LTHeaven/QLOCKOPlagiat/BndUhr/BndUhr.pdf

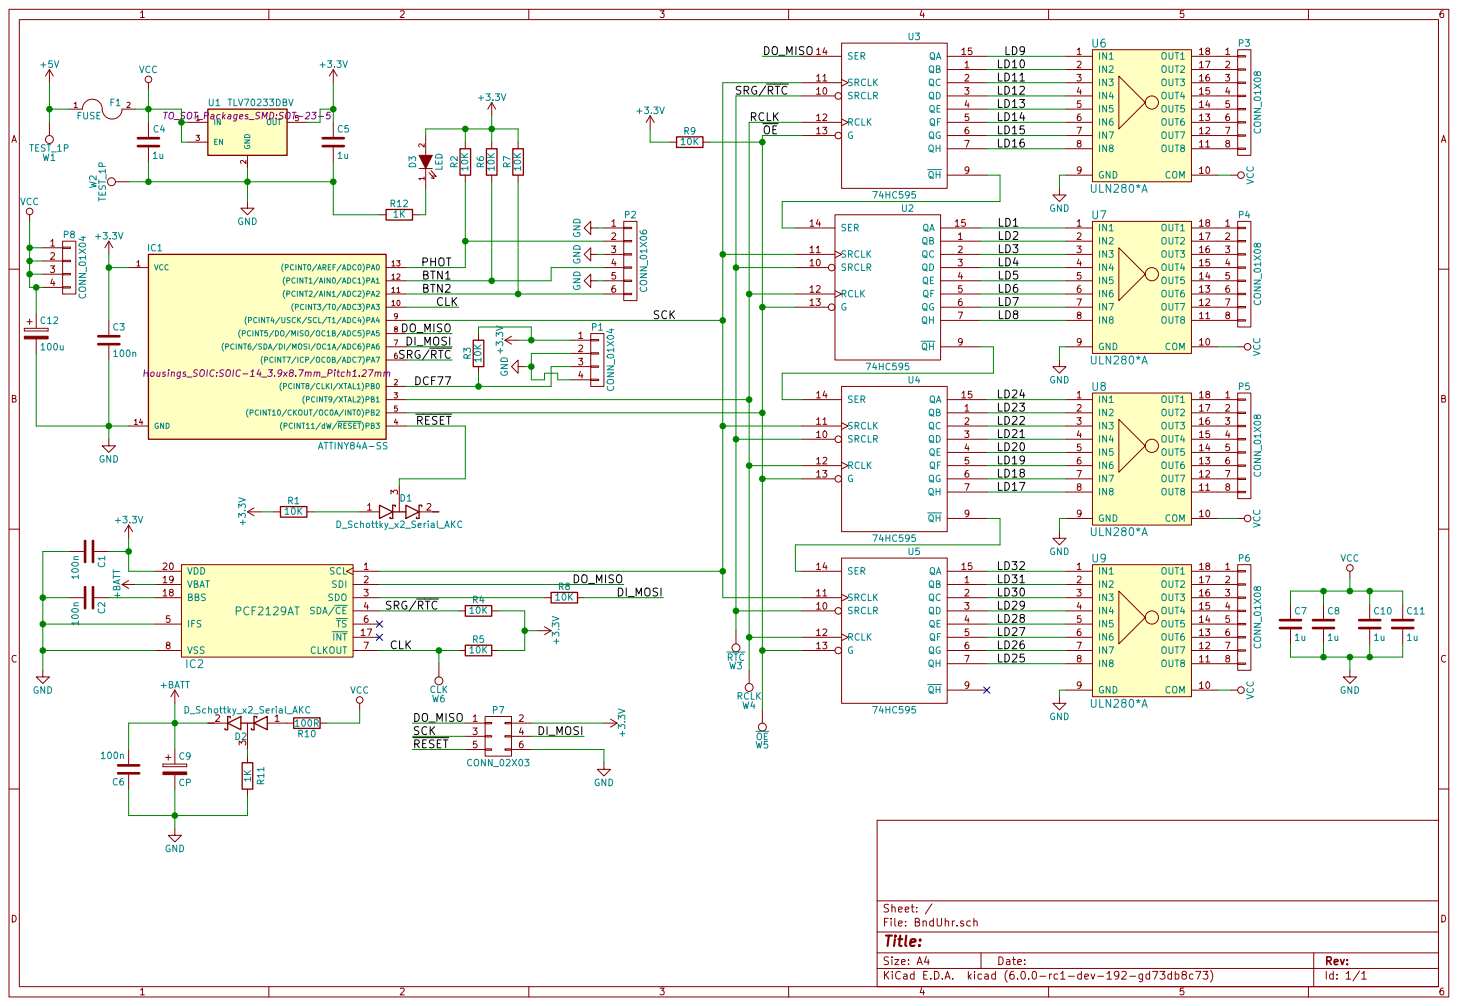
[picture p1: page 1]

LD10 | IN2 2
LD11 | IN3 3

LD20 | IN5 5
LD19 | IN6 6
LD18 | IN7 7
LD17

LD28 | IN5 5
LD27 | IN6 6
LD26 | IN7 7
LD25

Id: 1/1 Title: File: BndUhr.sch Sheet: /
