LTHeaven/QLOCKOPlagiat/BndUhr/BndUhr.kicad_pcb

## KiCad design BndUhr/BndUhr.kicad_pcb (2018-09-23)

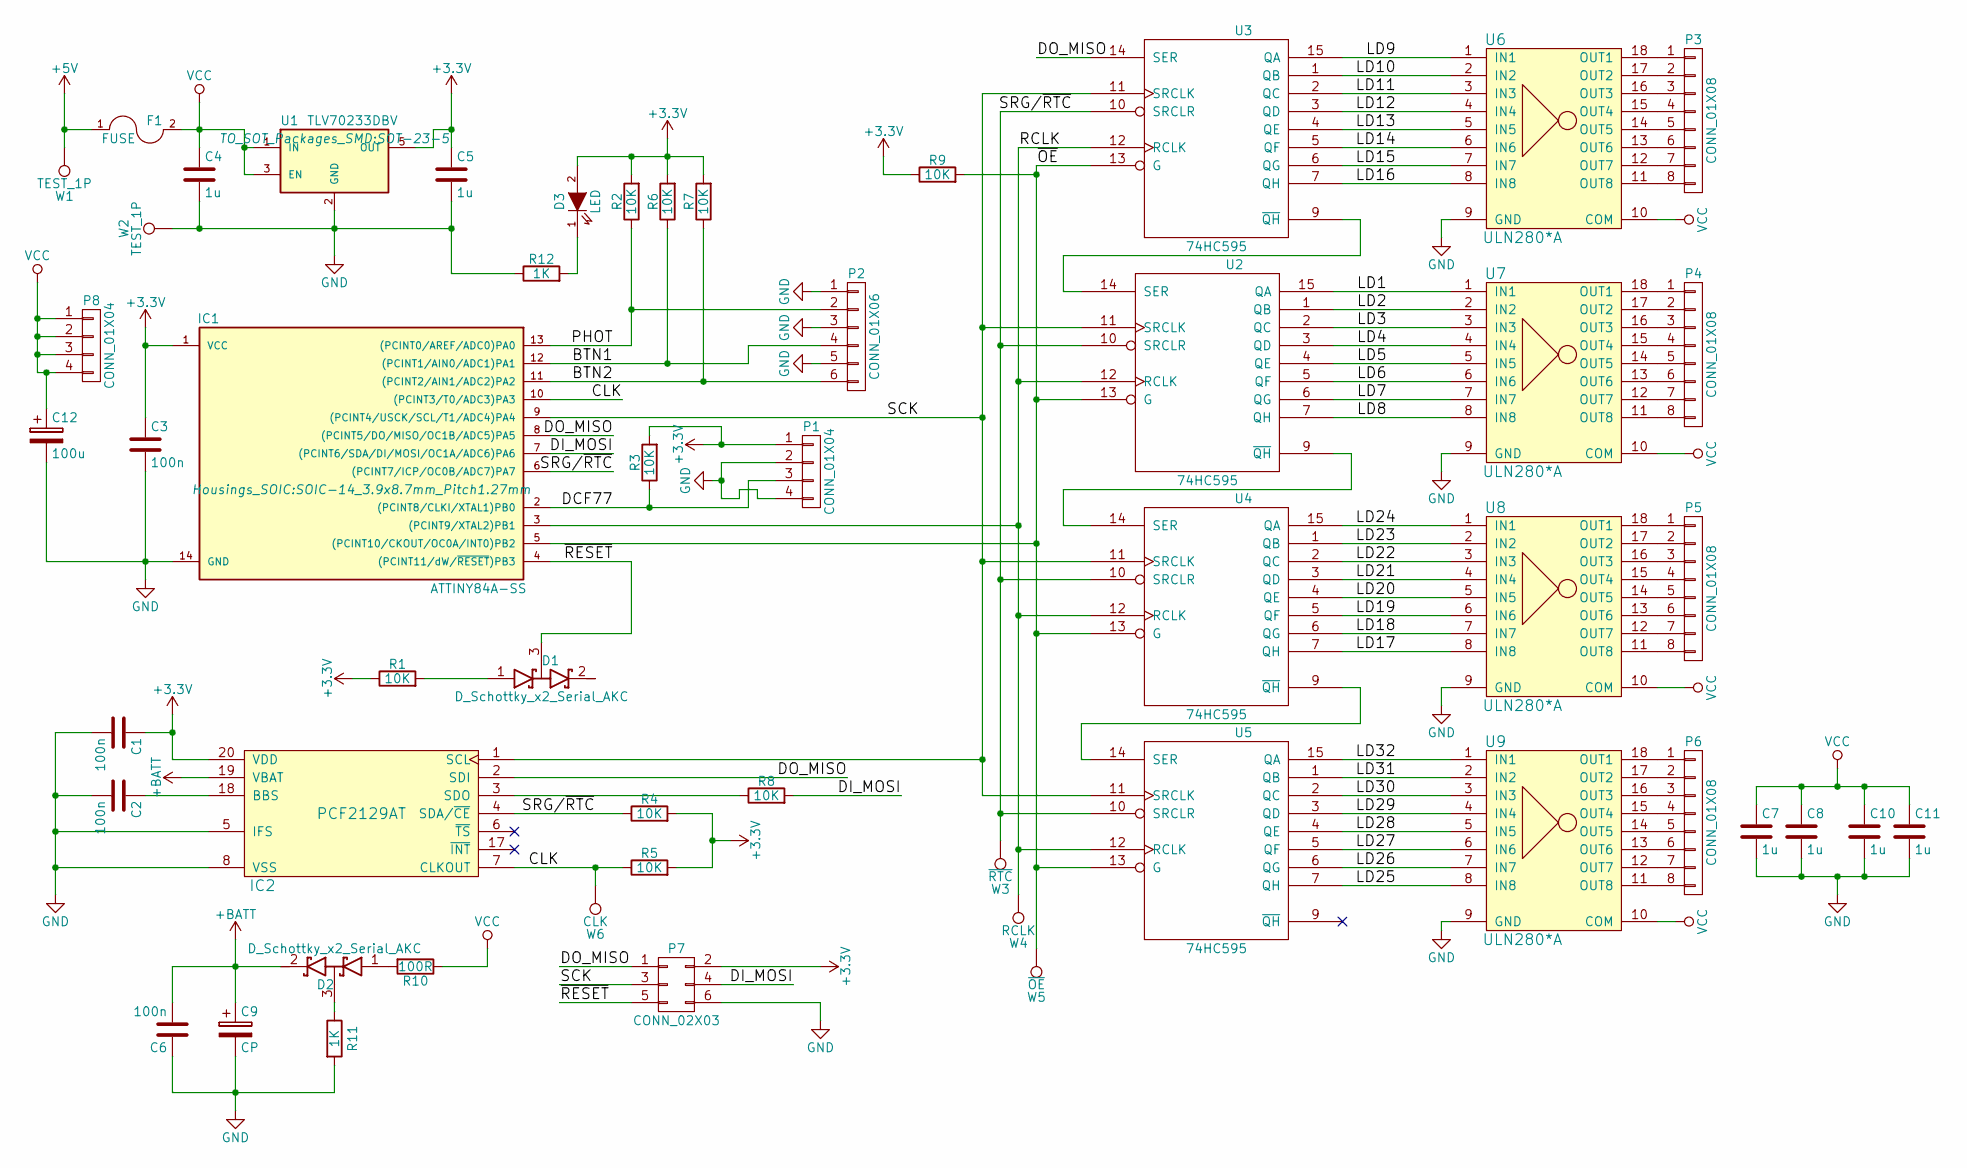
[picture p2: schematic BndUhr.sch]

Parts:
C1, C2, C3, C6: 100n; C_0603
C4, C5, C7, C8, C10, C11: 1u; C_0603
C9: CP; Panasonic-SuperCap-20mm
C12: 100u; CP_Radial_D8.0mm_P5.00mm
D1, D2: D_Schottky_x2_Serial_AKC; SOT-23
D3: LED; LED_1206
F1: FUSE; Fuseholder5x20_horiz_open_universal_Type-III
IC1: ATTINY84A-SS; SOIC-14_3.9x8.7mm_Pitch1.27mm
IC2: PCF2129AT; SOIC-20W_7.5x12.8mm_Pitch1.27mm
P1, P8: CONN_01X04; Pin_Header_Straight_1x04_Pitch2.54mm
P2: CONN_01X06; Pin_Header_Straight_1x06_Pitch2.54mm
P3, P4, P5, P6: CONN_01X08; Pin_Header_Angled_1x08_Pitch2.54mm
P7: CONN_02X03; IDC_Header_Straight_6pins
R1, R2, R3, R4, R5, R6, R7, R8, R9: 10K; R_0603
R10: 100R; R_0603
R11, R12: 1K; R_0603
U1: TLV70233DBV; SOT-23-5
U2, U3, U4, U5: 74HC595; SOIC-16_3.9x9.9mm_Pitch1.27mm
U6, U7, U8, U9: ULN280*A; DIP-18_W7.62mm
W1, W2: TEST_1P; SolderWirePad_single_2-5mmDrill
W3: ~RTC; Measurement_Point_Round-SMD-Pad_Small
W4: RCLK; Measurement_Point_Round-SMD-Pad_Small
W5: ~OE; Measurement_Point_Round-SMD-Pad_Small
W6: CLK; Measurement_Point_Round-SMD-Pad_Small

Connections:
+3V3: C1.1, C3.1, C5.1, D3.2 (A), IC1.1 (VCC), IC2.20 (VDD), P1.1, P7.2, R1.1, R2.2, R3.2, R4.2, R5.2, R6.2, R7.2, R9.1, U1.5 (OUT)
+5V: F1.1, W1.1
+BATT: C6.2, C9.1, D2.2 (K), IC2.19 (VBAT)
/BTN1: IC1.12 ((PCINT1/AIN0/ADC1)PA1), P2.4, R6.1
/BTN2: IC1.11 ((PCINT2/AIN1/ADC2)PA2), P2.6, R7.1
/CLK: IC1.10 ((PCINT3/T0/ADC3)PA3), IC2.7 (CLKOUT), R5.1, W6.1
/DCF77: IC1.2 ((PCINT8/CLKI/XTAL1)PB0), P1.3, R3.1
/DI_MOSI: IC1.7 ((PCINT6/SDA/DI/MOSI/OC1A/ADC6)PA6), P7.4, R8.2
/DO_MISO: IC1.8 ((PCINT5/DO/MISO/OC1B/ADC5)PA5), IC2.2 (SDI), P7.1, U3.14 (SER)
/LD1: U2.15 (QA), U7.1 (IN1)
/LD2: U2.1 (QB), U7.2 (IN2)
/LD3: U2.2 (QC), U7.3 (IN3)
/LD4: U2.3 (QD), U7.4 (IN4)
/LD5: U2.4 (QE), U7.5 (IN5)
/LD6: U2.5 (QF), U7.6 (IN6)
/LD7: U2.6 (QG), U7.7 (IN7)
/LD8: U2.7 (QH), U7.8 (IN8)
/LD9: U3.15 (QA), U6.1 (IN1)
/LD10: U3.1 (QB), U6.2 (IN2)
/LD11: U3.2 (QC), U6.3 (IN3)
/LD12: U3.3 (QD), U6.4 (IN4)
/LD13: U3.4 (QE), U6.5 (IN5)
/LD14: U3.5 (QF), U6.6 (IN6)
/LD15: U3.6 (QG), U6.7 (IN7)
/LD16: U3.7 (QH), U6.8 (IN8)
/LD17: U4.7 (QH), U8.8 (IN8)
/LD18: U4.6 (QG), U8.7 (IN7)
/LD19: U4.5 (QF), U8.6 (IN6)
/LD20: U4.4 (QE), U8.5 (IN5)
/LD21: U4.3 (QD), U8.4 (IN4)
/LD22: U4.2 (QC), U8.3 (IN3)
/LD23: U4.1 (QB), U8.2 (IN2)
/LD24: U4.15 (QA), U8.1 (IN1)
/LD25: U5.7 (QH), U9.8 (IN8)
/LD26: U5.6 (QG), U9.7 (IN7)
/LD27: U5.5 (QF), U9.6 (IN6)
/LD28: U5.4 (QE), U9.5 (IN5)
/LD29: U5.3 (QD), U9.4 (IN4)
/LD30: U5.2 (QC), U9.3 (IN3)
/LD31: U5.1 (QB), U9.2 (IN2)
/LD32: U5.15 (QA), U9.1 (IN1)
/PHOT: IC1.13 ((PCINT0/AREF/ADC0)PA0), P2.2, R2.1
/RCLK: IC1.3 ((PCINT9/XTAL2)PB1), U2.12 (RCLK), U3.12 (RCLK), U4.12 (RCLK), U5.12 (RCLK), W4.1
/SCK: IC1.9 ((PCINT4/USCK/SCL/T1/ADC4)PA4), IC2.1 (SCL), P7.3, U2.11 (SRCLK), U3.11 (SRCLK), U4.11 (SRCLK), U5.11 (SRCLK)
/SRG/~RTC: IC1.6 ((PCINT7/ICP/OC0B/ADC7)PA7), IC2.4 (SDA/~CE), R4.1, U2.10 (SRCLR), U3.10 (SRCLR), U4.10 (SRCLR), U5.10 (SRCLR), W3.1
/~OE: IC1.5 ((PCINT10/CKOUT/OC0A/INT0)PB2), R9.2, U2.13 (G), U3.13 (G), U4.13 (G), U5.13 (G), W5.1
/~RESET: D1.3 (common), IC1.4 ((PCINT11/dW/~RESET~)PB3), P7.5
GND: C1.2, C2.2, C3.2, C4.2, C5.2, C6.1, C7.2, C8.2, C9.2, C10.2, C11.2, C12.2, IC1.14 (GND), IC2.5 (IFS), IC2.8 (VSS), P1.2, P1.4, P2.1, P2.3, P2.5, P7.6, R11.2, R12.1, U1.2 (GND), U2.8 (GND), U3.8 (GND), U4.8 (GND), U5.8 (GND), U6.9 (GND), U7.9 (GND), U8.9 (GND), U9.9 (GND), W2.1
unnamed: C2.1, IC2.18 (BBS)
unnamed: D1.1 (A), R1.2
unnamed: D2.1 (A), R10.2
unnamed: D2.3 (common), R11.1
unnamed: D3.1 (K), R12.2
unnamed: IC2.3 (SDO), R8.1
unnamed: P3.1, U6.18 (OUT1)
unnamed: P3.2, U6.17 (OUT2)
unnamed: P3.3, U6.16 (OUT3)
unnamed: P3.4, U6.15 (OUT4)
unnamed: P3.5, U6.14 (OUT5)
unnamed: P3.6, U6.13 (OUT6)
unnamed: P3.7, U6.12 (OUT7)
unnamed: P3.8, U6.11 (OUT8)
unnamed: P4.1, U7.18 (OUT1)
unnamed: P4.2, U7.17 (OUT2)
unnamed: P4.3, U7.16 (OUT3)
unnamed: P4.4, U7.15 (OUT4)
unnamed: P4.5, U7.14 (OUT5)
unnamed: P4.6, U7.13 (OUT6)
unnamed: P4.7, U7.12 (OUT7)
unnamed: P4.8, U7.11 (OUT8)
unnamed: P5.1, U8.18 (OUT1)
unnamed: P5.2, U8.17 (OUT2)
unnamed: P5.3, U8.16 (OUT3)
unnamed: P5.4, U8.15 (OUT4)
unnamed: P5.5, U8.14 (OUT5)
unnamed: P5.6, U8.13 (OUT6)
unnamed: P5.7, U8.12 (OUT7)
unnamed: P5.8, U8.11 (OUT8)
unnamed: P6.1, U9.18 (OUT1)
unnamed: P6.2, U9.17 (OUT2)
unnamed: P6.3, U9.16 (OUT3)
unnamed: P6.4, U9.15 (OUT4)
unnamed: P6.5, U9.14 (OUT5)
unnamed: P6.6, U9.13 (OUT6)
unnamed: P6.7, U9.12 (OUT7)
unnamed: P6.8, U9.11 (OUT8)
unnamed: U2.9 (~QH), U4.14 (SER)
unnamed: U2.14 (SER), U3.9 (~QH)
unnamed: U4.9 (~QH), U5.14 (SER)
VCC: C4.1, C7.1, C8.1, C10.1, C11.1, C12.1, F1.2, P8.1, P8.2, P8.3, P8.4, R10.1, U1.1 (IN), U1.3 (EN), U2.16 (VCC), U3.16 (VCC), U4.16 (VCC), U5.16 (VCC), U6.10 (COM), U7.10 (COM), U8.10 (COM), U9.10 (COM)

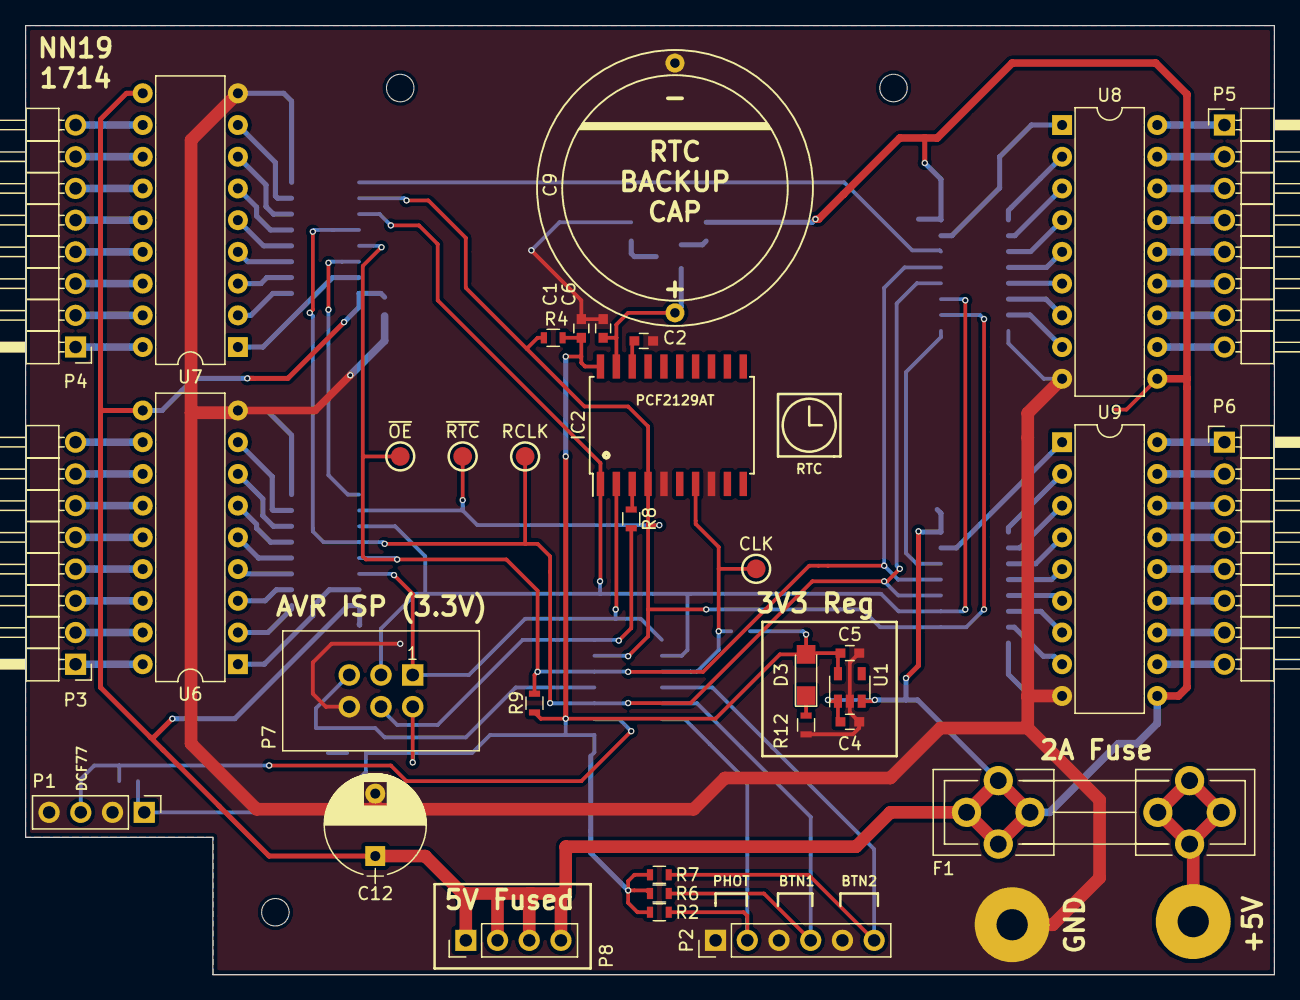
[picture p3: board BndUhr.kicad_pcb from above]

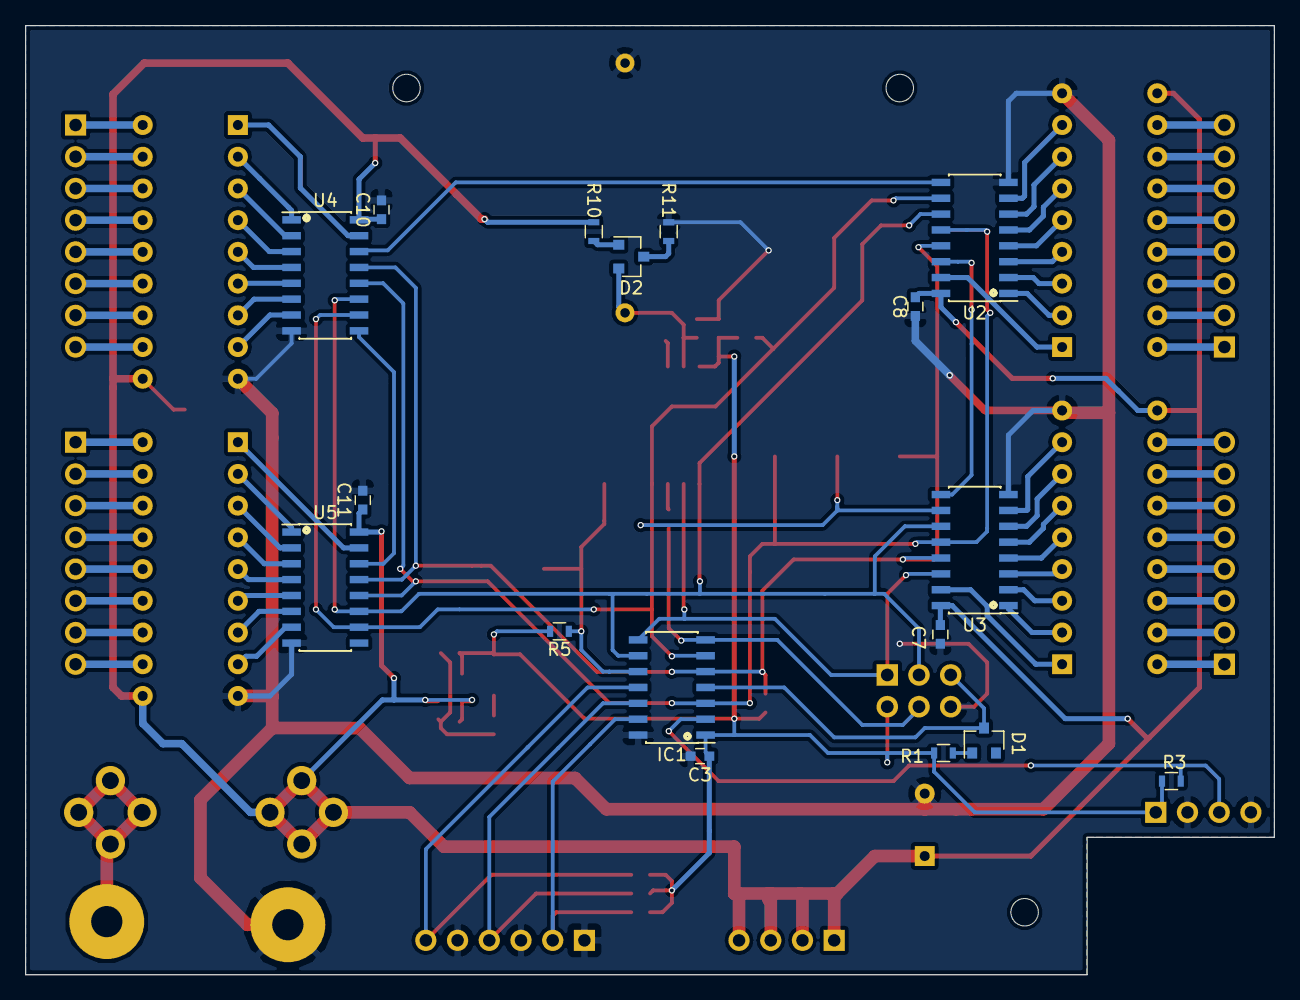
[picture p4: board BndUhr.kicad_pcb from below]

Board: 2 copper layers, 100.0 x 76.0 mm, 53 parts (17 on the bottom side), 90 nets.
