LTHeaven/QLOCKOPlagiat/(commit log)

2018-09-15 current status
2018-09-15 removed debug since time is now displayed correctly (hopefully)
    [bndrtc.c]
2018-09-15 could not work, implemented correct dcf77 handling
    [bndrtc.c]
2018-09-15 switched to rtc board use, added funk info
2018-09-23 added board stuff
    [BndUhr-2018-09-15-15-55-23.sch, BndUhr-2018-09-23-00-42-20.sch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]
